AutomationArt/AA_carbattery7/Image/2_2.png

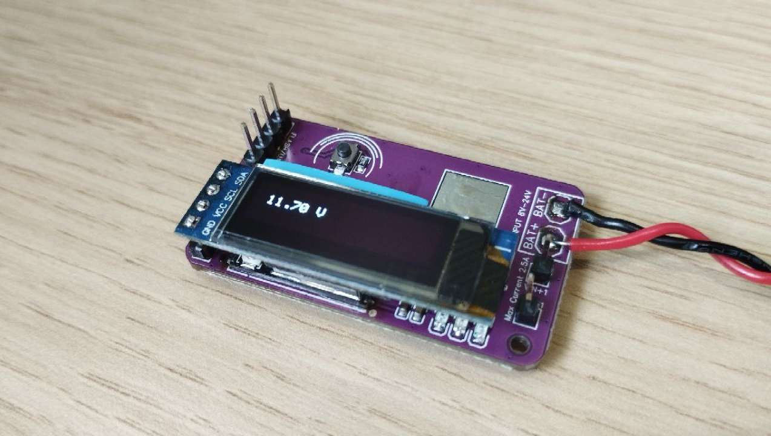
Image/2_2.png
