AutomationArt/AA_carbattery7/Pcb/BOM_PCB_AA CARBAT.csv

ID | Name | Designator | Footprint | Quantity | Manufacturer Part | Manufacturer | Supplier | Supplier Part | Price | Pins | 3DModel | Contributor | Frequency | Package Display | Pitch | Resistance | Resistance (Ohms) | link
1 | Boot/Flash | BOOT1 | SW-SMD_L4.0-W2.9-LS5.0 | 1 | Switch3x4x2 | ReliaPro | LCSC | C26638 |  | 2 | SW-SMD_L4.0-W2.9-H2-LS5.0 | 立创EDA官方封装库 |  |  |  |  |  | https://item.szlcsc.com/330471.html
2 | Reset | RST1 | SW-SMD_L4.0-W2.9-LS5.0 | 1 | Switch3x4x2 | ReliaPro | LCSC | C26638 |  | 2 | SW-SMD_L4.0-W2.9-H2-LS5.0 | 立创EDA官方封装库 |  |  |  |  |  | https://item.szlcsc.com/330471.html
3 | FLASH/UART | U14 | 4PINS | 1 |  |  |  |  |  | 4 | 4pin 2.54 pin header | Chinz
4 | 10K | R16,R15,R7,R9,R10,R11,R13,R14 | R0603 | 8 | RC0603DR-0710KL | YAGEO(国巨) | LCSC | C137819 | 0.009 | 2 | R0603 | LCSC |  |  |  | 10kΩ |  | https://www.mouser.in/datasheet/2/447/PYu_RT_1_to_0_01_RoHS_L_11-1669912.pdf
5 | MLT-7525 | BUZZER1 | BUZ-SMD_4P-L7.5-W7.5-P7.59-TL | 1 | MLT-7525 | 华能 | LCSC | C95299 | 0.267 | 4 | BUZ-SMD_4P-L7.5-W7.5-H2.5 | LCSC | 2700Hz |  |  |  |  | https://item.szlcsc.com/96501.html
6 | AP2112K | U2 | SOT-25-5_L3.0-W1.8-P0.95-LS3.0-BR | 1 | AP2112K-3.3TRG1 | DIODES | LCSC | C51118 | 0.07 | 5 | SOT-25-5_L3.0-W1.6-H1.3-LS2.8-P0.95 | LCSC |  | No |  |  |  | https://item.szlcsc.com/70677.html
7 | FLASH/UART | U10 | 4PINS | 1 |  |  |  |  |  | 4 | 4pin 2.54 pin header | Chinz |  | Yes
8 | 100nF | C8,C11 | C0603 | 2 | CC0603ZRY5V9BB104 | YAGEO(国巨) | LCSC | C106221 | 0.003 | 2 | C0603_L1.6-W0.8-H0.8 | lcsc |  |  |  |  |  | https://item.szlcsc.com/362304.html
9 | 1uF | C9 | C0603 | 1 | CC0603KRX5R6BB105 | YAGEO(国巨) | LCSC | C106214 | 0.006 | 2 | C0603_L1.6-W0.8-H0.8 | LCSC |  |  |  |  |  | https://item.szlcsc.com/362304.html
10 | 10nF | U5,U1,U4 | C0603 | 3 | C1608NP01H103J080AA | TDK | LCSC | C2170498 | 0.407 | 2 | C0603_L1.6-W0.8-H0.8 | lcsc |  |  |  |  |  | https://atta.szlcsc.com/upload/public/pdf/source/20211207/E9BA3F2A35302C8FCC86590608278AEF.pdf
11 | ESP32-C3-WROOM-02U | U8 | ESP32-C3-WROOM-02U | 1 |  | Espressif Systems |  |  |  | 19 | WIFIM-SMD_18P-L14.3-W18.0-H3.2-P1.50 | LCSC
12 | 110Ω | U9,U12,U13 | R0603 | 3 | HPCR0603F110RK9 | RESI(开步睿思） | LCSC | C365068 | 0.007 | 2 | R0603 | LCSC |  |  |  |  | 110 | https://www.mouser.in/datasheet/2/447/PYu_RT_1_to_0_01_RoHS_L_11-1669912.pdf
13 | RED | LED2 | LED0805-RD_RED | 1 | HL-PSC-2012S35FC-CZ | HONGLITRONIC(鸿利光电) | LCSC | C497953 | 0.043 | 2 | LED0805-RD_RED | LCSC |  |  |  |  |  | https://img.jlc.com/pdf/applyPasteComponent/2021-07-17/587229S/872bb7bebafd4c6c829f204d6b6cd866/C84256_红灯0805贴片LED_2020-08-20.PDF
14 | GREEN | LED3 | LED0805-RD_GREEN | 1 | NCD2012C1 | 国星光电 | LCSC | C2917179 | 0.023 | 2 | LED0805-RD_GREEN | LCSC |  |  |  |  |  | https://item.szlcsc.com/255094.html
15 | YELLOW | LED1 | LED0805-RD_YELLOW | 1 | XL-1005UYC | XINGLIGHT(成兴光) | LCSC | C965792 | 0.011 | 2 | LED0805_Green | LCSC |  |  |  |  |  | https://img.jlc.com/pdf/applyPasteComponent/2021-07-17/587229S/56514d832a0844c2bde79c66c9b0afa6/C84256_%E7%BA%A2%E7%81%AF0805%E8%B4%B4%E7%89%87LED_2020-08-20.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
16 | 2 PIN CON (BATTERY) | CON1 | 2PIN-CON-BATT [PCB] | 1 |  |  |  |  |  | 2 |  | SparkFun
17 | Header-Male-2.54_1x1 | VIN+1,VIN-1 | HDR-1X1/2.54 | 2 | Header-Male-2.54_1x1 | ReliaPro | LCSC | C81276 | 0.007 | 1
18 | Button Free | BF | SW-SMD_L4.0-W2.9-LS5.0 | 1 | Switch3x4x2 | ReliaPro | LCSC | C26638 |  | 2 | SW-SMD_L4.0-W2.9-H2-LS5.0 | 立创EDA官方封装库 |  |  |  |  |  | https://item.szlcsc.com/330471.html
19 | 4.7kΩ | R8 | R0603 | 1 | RMC06034K7FN | Tyohm(幸亚电阻) | LCSC | C269713 | 0.003 | 2 | R0603 | LCSC |  |  |  |  | 4.7K | https://www.mouser.in/datasheet/2/447/PYu_RT_1_to_0_01_RoHS_L_11-1669912.pdf
20 | 3 PIN SMD HEADER AV | U7 | 3 PIN SMD HEADER | 1 |  |  |  |  |  | 3 |  | szegabesz |  |  | 2.54
21 | PDTC114TT,215 | Q3 | SOT-23-3_L2.9-W1.3-P1.90-LS2.4-BR | 1 | PDTC114TT,215 | Nexperia | LCSC | C552156 | 0.029 | 3 | SOT-23-3P_L2.9-W1.3-H1.0-LS2.4-P0.95 | LCSC |  |  |  |  |  | https://www.diodes.com/assets/Package-Files/SOT23.pdf
22 | 68uF | C1 | CAP-SMD_L6.0-W3.2 | 1 | CA45-C-10V-68μF-K | TORCH(火炬) | LCSC | C503923 | 0.332 | 2 | CASE-C_L6.0-W3.2-H2.7 | LCSC |  |  |  |  |  | https://item.szlcsc.com/22955.html
23 | 47uF | C2,C3 | C1206 | 2 | CC1206MKX5R5BB476 | YAGEO(国巨) | LCSC | C110047 | 0.091 | 2 | C1206_L3.2-W1.6-H1.3 | lcsc |  |  |  |  |  | https://item.szlcsc.com/89171.html
24 | 2.2uF | C5,C4 | C0603 | 2 | 0603B225K160NT | FH(风华) | LCSC | C43922 | 0.02 | 2 | C0603_L1.6-W0.8-H0.8 | lcsc |  |  |  |  |  | https://item.szlcsc.com/362304.html
25 | 33pF | C6 | C0603 | 1 | CC0603FRNPO0BN330 | YAGEO(国巨) | LCSC | C527043 | 0.011 | 2 | C0603_L1.6-W0.8-H0.8 | LCSC |  |  |  |  |  | https://item.szlcsc.com/362304.html
26 | 5.6nF | C7 | C0603 | 1 | CC0603KRX7R9BB562 | YAGEO(国巨) | LCSC | C107095 | 0.003 | 2 | C0603_L1.6-W0.8-H0.8 | lcsc |  |  |  |  |  | https://item.szlcsc.com/362304.html
27 | B360A-13-F | D1 | SMA_L4.4-W2.6-LS5.0-RD | 1 | B360A-13-F | DIODES(美台) | LCSC | C94193 | 0.068 | 2 | SMA_L4.4-W2.6-LS5.0-RD | lcsc |  |  |  |  |  | https://item.szlcsc.com/301402.html
28 | 10uH | L1 | IND-SMD_L7.1-W6.6 | 1 | MWSA0603S-100MT | Sunlord(顺络) | LCSC | C132141 | 0.09 | 2 | IND-SMD_L6.6-W7.1-H3.0 | LCSC |  |  |  |  |  | https://item.szlcsc.com/421431.html
29 | 37.4kΩ | R2 | R0603 | 1 | 0603WAF3742T5E | UNI-ROYAL(厚声) | LCSC | C23033 | 0.001 | 2 | R0603 | lcsc |  |  |  |  | 37.4K | https://www.mouser.in/datasheet/2/447/PYu_RT_1_to_0_01_RoHS_L_11-1669912.pdf
30 | 0.1 | R12 | 2512 | 1 | MA251220JR100FZ | Ever Ohms Tech | LCSC | C252670 | 0.122 | 2 | RES-SMD_L6.4-W3.2_LR2512D-3W-1MR | LCSC
31 | TPS54240DGQR | U3 | MSOP-10_L3.0-W3.0-P0.50-LS5.0-BL-EP | 1 | TPS54240DGQR | TI(德州仪器) | LCSC | C53213 | 0.594 | 11 | MSOP-10_L3.0-W3.0-H1.1-LS5.0-P0.50 | lcsc |  |  |  |  |  | https://item.szlcsc.com/109129.html
32 | INA219AIDR | U11 | SOIC-8_L4.9-W3.9-P1.27-LS6.0-BL | 1 | INA219AIDR | TI(德州仪器) | LCSC | C138706 | 1.163 | 8 | SOIC-8_L4.9-W3.9-H1.7-LS6.0-P1.27 | LCSC |  |  |  |  |  | https://so.szlcsc.com/global.html?c=&k=C9843
33 | 332K | R1 | R0603 | 1 | RC0603FR-07332KL | YAGEO(国巨) | LCSC | C309562 | 0.001 | 2 | R0603 | LCSC |  |  |  | 332kΩ |  | https://www.mouser.in/datasheet/2/447/PYu_RT_1_to_0_01_RoHS_L_11-1669912.pdf
34 | 56.2K | R3 | R0603 | 1 | AC0603DR-0756K2L | YAGEO(国巨) | LCSC | C227508 | 0.006 | 2 | R0603 | LCSC |  |  |  | 56.2kΩ |  | https://www.mouser.in/datasheet/2/447/PYu_RT_1_to_0_01_RoHS_L_11-1669912.pdf
35 | 20K | R4 | R0603 | 1 | AF0603FR-0720KL | YAGEO(国巨) | LCSC | C144093 | 0.005 | 2 | R0603 | LCSC |  |  |  | 20kΩ |  | https://www.mouser.in/datasheet/2/447/PYu_RT_1_to_0_01_RoHS_L_11-1669912.pdf
36 | 237kΩ | R5 | R0603 | 1 | RC0603FR-07237KL | YAGEO(国巨) | LCSC | C188262 | 0.001 | 2 | R0603 | LCSC |  |  |  |  | 237K | https://www.mouser.in/datasheet/2/447/PYu_RT_1_to_0_01_RoHS_L_11-1669912.pdf
