AutomationArt/AA_carbattery7/Pcb/Schematic_AA CARBAT.pdf

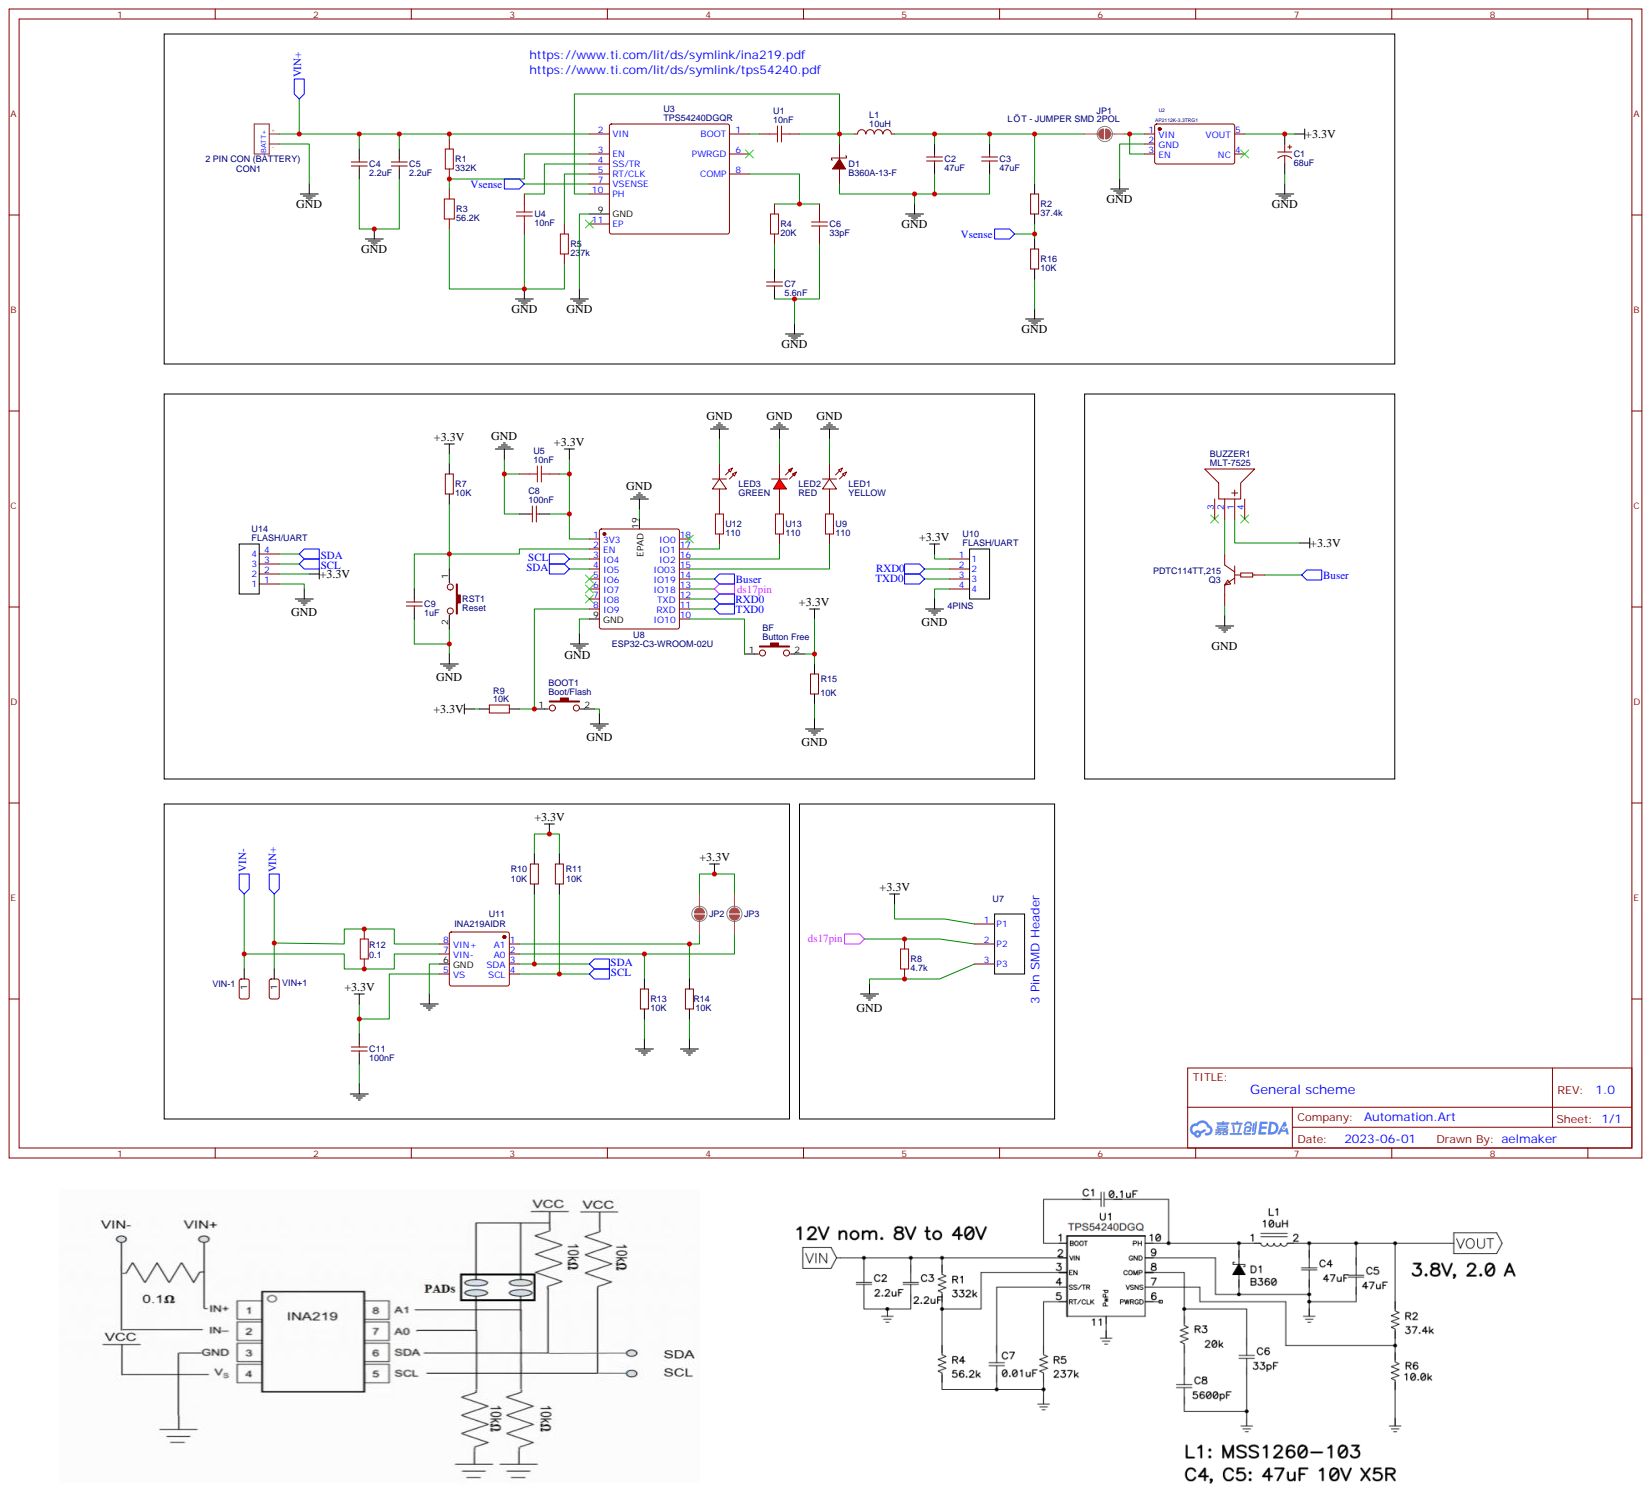
[picture p7: page 1]

https://www.ti.com/lit/ds/symlink/ina219.pdf
https://www.ti.com/lit/ds/symlink/tps54240.pdf
